dragonmux/xiaomao/xiaomao.kicad_sch

## KiCad design xiaomao.kicad_sch (2024-12-28)

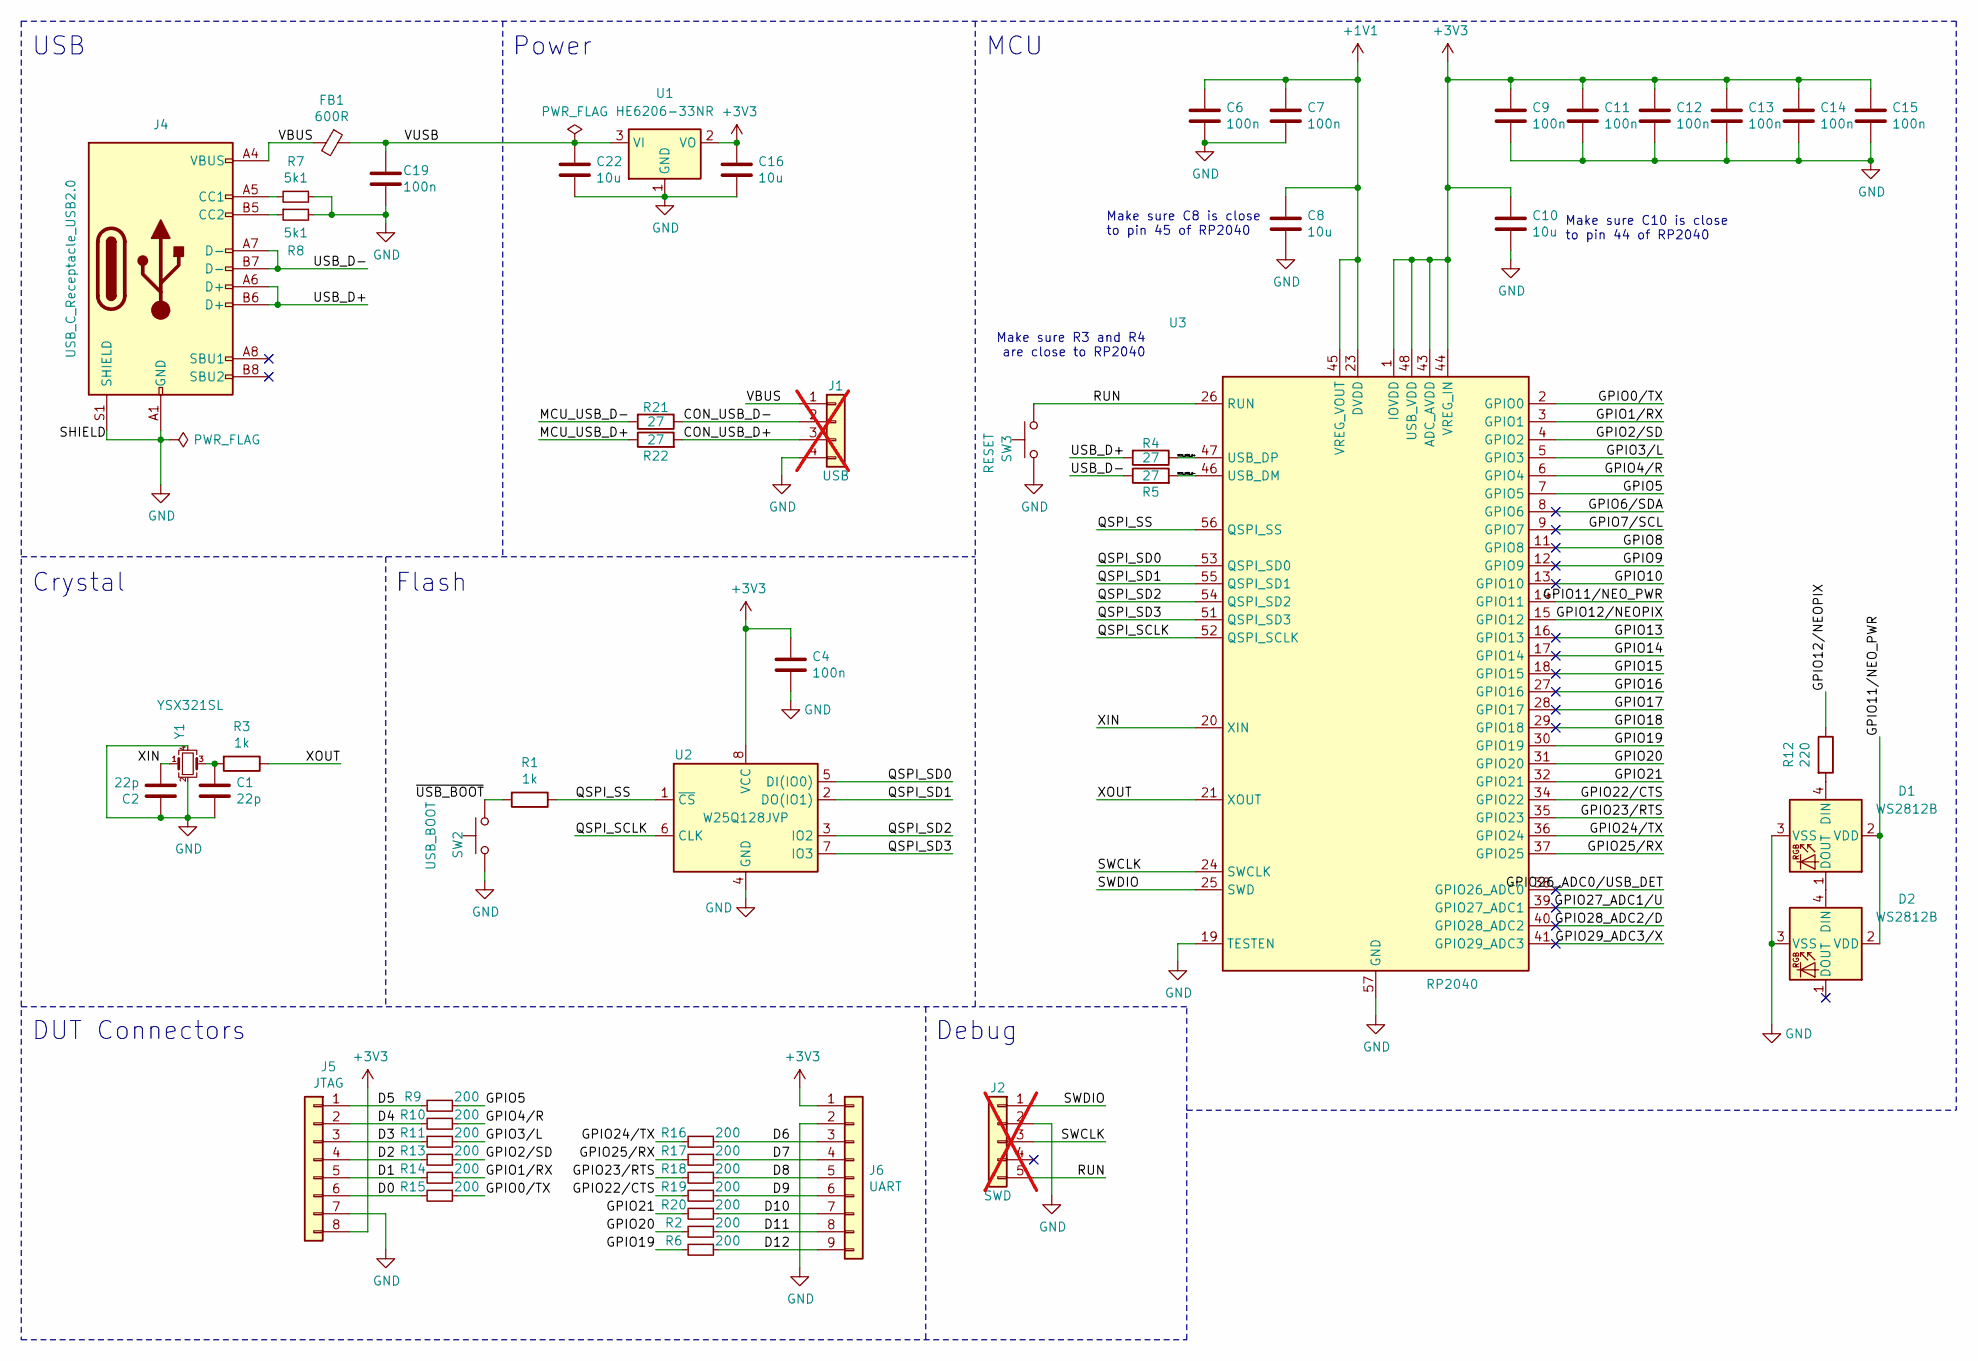
[picture p1: schematic xiaomao.kicad_sch]

Parts:
C1, C2: 22p; C0402; LCSC C1555
C4, C6, C7, C9, C11, C12, C13, C14, C15, C19: 100n; C0402; LCSC C1525
C8, C10, C16, C22: 10u; C0402; LCSC C15525
D1, D2: WS2812B; LED_WS2812B_PLCC4_1x1mm; LCSC C5349953
FB1: 600R; L0402; LCSC C1002
J1: USB; PinHeader_1x04_P2.54mm_Vertical; not fitted
J2: SWD; PinHeader_1x05_P1.27mm_Vertical; not fitted
J4: USB_C_Receptacle_USB2.0; USB_C_Receptacle_HRO_TYPE-C-31-M-12; LCSC C2927038
J5: JTAG; PinHeader_1x08_P2.54mm_Horizontal; LCSC C706871
J6: UART; PinHeader_1x09_P2.54mm_Horizontal; LCSC C706872
R1, R3: 1k; R0402; LCSC C11702
R2, R6, R9, R10, R11, R13, R14, R15, R16, R17, R18, R19, R20: 200; R0603; LCSC C8218
R4, R5, R21, R22: 27; R0402; LCSC C25100
R7, R8: 5k1; R0402; LCSC C25905
R12: 220; R0402; LCSC C25091
SW2: USB_BOOT; B3U-1000P-B; LCSC C2905194
SW3: RESET; B3U-1000P-B; LCSC C2905194
U1: HE6206-33NR; SOT-23; LCSC C5446
U2: W25Q128JVP; UDFN-8-1EP_6x5mm_P1.27mm_EP3.4x4mm; LCSC C190862
U3: RP2040; QFN-56-1EP_7x7mm_P0.4mm_EP3.2x3.2mm; LCSC C2040
Y1: YSX321SL; SMD3225; LCSC C9002

Connections:
+1V1: C6.1, C7.1, C8.1, U3.23 (DVDD), U3.45 (VREG_VOUT), U3.50 (DVDD)
+3V3: C4.1, C9.1, C10.1, C11.1, C12.1, C13.1, C14.1, C15.1, C16.1, J5.8, J6.1, U1.2 (VO), U2.8 (VCC), U3.1 (IOVDD), U3.10 (IOVDD), U3.22 (IOVDD), U3.33 (IOVDD), U3.42 (IOVDD), U3.43 (ADC_AVDD), U3.44 (VREG_IN), U3.48 (USB_VDD), U3.49 (IOVDD)
CON_USB_D+: J1.3, R22.2
CON_USB_D-: J1.2, R21.1
D0: J5.6, R15.2
D1: J5.5, R14.2
D2: J5.4, R13.2
D3: J5.3, R11.2
D4: J5.2, R10.2
D5: J5.1, R9.2
D6: J6.3, R16.1
D7: J6.4, R17.1
D8: J6.5, R18.1
D9: J6.6, R19.1
D10: J6.7, R20.1
D11: J6.8, R2.1
D12: J6.9, R6.1
GND: C1.2, C2.1, C4.2, C6.2, C7.2, C8.2, C9.2, C10.2, C11.2, C12.2, C13.2, C14.2, C15.2, C16.2, C19.2, C22.2, D1.3 (VSS), D2.3 (VSS), J1.4, J2.2, J4.A1 (GND), J4.A12 (GND), J4.B1 (GND), J4.B12 (GND), J4.S1 (SHIELD), J5.7, J6.2, R7.1, R8.2, SW2.2, SW3.2, U1.1 (GND), U2.4 (GND), U2.9 (GND), U3.19 (TESTEN), U3.57 (GND), Y1.2, Y1.4
GPIO0/TX: R15.1, U3.2 (GPIO0)
GPIO1/RX: R14.1, U3.3 (GPIO1)
GPIO2/SD: R13.1, U3.4 (GPIO2)
GPIO3/L: R11.1, U3.5 (GPIO3)
GPIO4/R: R10.1, U3.6 (GPIO4)
GPIO5: R9.1, U3.7 (GPIO5)
GPIO6/SDA: U3.8 (GPIO6)
GPIO7/SCL: U3.9 (GPIO7)
GPIO8: U3.11 (GPIO8)
GPIO9: U3.12 (GPIO9)
GPIO10: U3.13 (GPIO10)
GPIO11/NEO_PWR: D1.2 (VDD), D2.2 (VDD), U3.14 (GPIO11)
GPIO12/NEOPIX: R12.1, U3.15 (GPIO12)
GPIO13: U3.16 (GPIO13)
GPIO14: U3.17 (GPIO14)
GPIO15: U3.18 (GPIO15)
GPIO16: U3.27 (GPIO16)
GPIO17: U3.28 (GPIO17)
GPIO18: U3.29 (GPIO18)
GPIO19: R6.2, U3.30 (GPIO19)
GPIO20: R2.2, U3.31 (GPIO20)
GPIO21: R20.2, U3.32 (GPIO21)
GPIO22/CTS: R19.2, U3.34 (GPIO22)
GPIO23/RTS: R18.2, U3.35 (GPIO23)
GPIO24/TX: R16.2, U3.36 (GPIO24)
GPIO25/RX: R17.2, U3.37 (GPIO25)
GPIO26_ADC0/USB_DET: U3.38 (GPIO26_ADC0)
GPIO27_ADC1/U: U3.39 (GPIO27_ADC1)
GPIO28_ADC2/D: U3.40 (GPIO28_ADC2)
GPIO29_ADC3/X: U3.41 (GPIO29_ADC3)
MCU_USB_D+: R4.1, R22.1, U3.47 (USB_DP)
MCU_USB_D-: R5.2, R21.2, U3.46 (USB_DM)
unnamed: C1.1, R3.2, Y1.3
unnamed: D1.1 (DOUT), D2.4 (DIN)
unnamed: D1.4 (DIN), R12.2
unnamed: J4.A5 (CC1), R7.2
unnamed: J4.B5 (CC2), R8.1
QSPI_SCLK: U2.6 (CLK), U3.52 (QSPI_SCLK)
QSPI_SD0: U2.5 (DI(IO0)), U3.53 (QSPI_SD0)
QSPI_SD1: U2.2 (DO(IO1)), U3.55 (QSPI_SD1)
QSPI_SD2: U2.3 (IO2), U3.54 (QSPI_SD2)
QSPI_SD3: U2.7 (IO3), U3.51 (QSPI_SD3)
QSPI_SS: R1.1, U2.1 (~CS), U3.56 (QSPI_SS)
RUN: J2.5, SW3.1, U3.26 (RUN)
SWCLK: J2.3, U3.24 (SWCLK)
SWDIO: J2.1, U3.25 (SWD)
USB_D+: J4.A6 (D+), J4.B6 (D+), R4.2
USB_D-: J4.A7 (D-), J4.B7 (D-), R5.1
VBUS: FB1.2, J1.1, J4.A4 (VBUS), J4.A9 (VBUS), J4.B4 (VBUS), J4.B9 (VBUS)
VUSB: C19.1, C22.1, FB1.1, U1.3 (VI)
XIN: C2.2, U3.20 (XIN), Y1.1
XOUT: R3.1, U3.21 (XOUT)
~USB_BOOT: R1.2, SW2.1

Notes on the sheet:
Make sure C10 is close to pin 44 of RP2040
Make sure C8 is close to pin 45 of RP2040
USB
Make sure R3 and R4 are close to RP2040
Debug
Flash
Crystal
Power
MCU
DUT Connectors
