dragonmux/xiaomao/(notices)

Notices in the files:
xiaomao.kicad_sch:
License: CERN-OHL-S-2.0
